andreacalvo/pcb_ble_corbera/README.md

## BLE Corbera

Kicad design, BLE Temperature Humidity sensor
