andreacalvo/pcb_ble_corbera/pcb_ble_corbera.kicad_pcb

## KiCad design pcb_ble_corbera.kicad_pcb (2018-05-15)

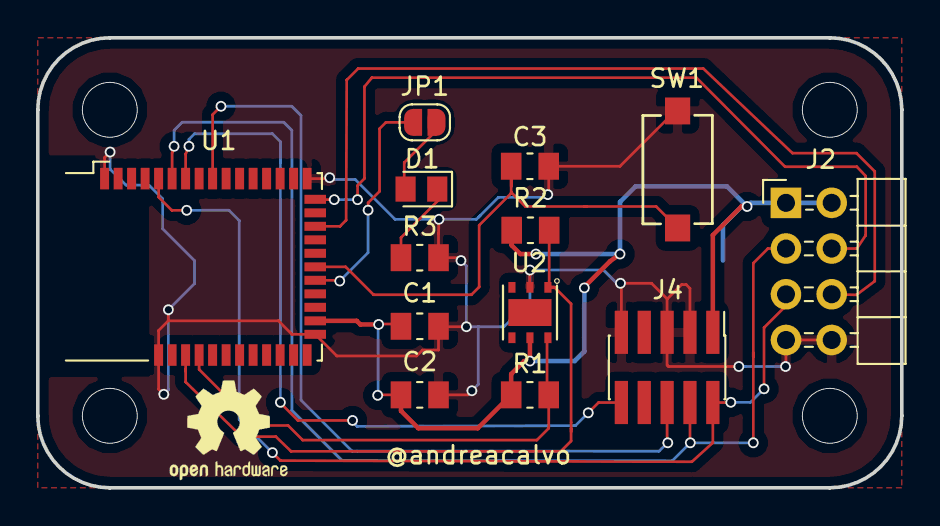
[picture p1: board pcb_ble_corbera.kicad_pcb from above]

Board: 2 copper layers, 48.0 x 25.0 mm, 14 parts (1 on the bottom side), 14 nets.

Parts:
C1: 0.1uF, 16V; C_0805_2012Metric_Pad1.15x1.50mm_HandSolder
C2: 100nF; C_0805_2012Metric_Pad1.15x1.50mm_HandSolder
C3: 104pF; C_0805_2012Metric_Pad1.15x1.50mm_HandSolder
D1: LED; LED_0805_2012Metric_Pad1.12x1.40mm_HandSolder
J1: Battery_Cell; Keystone_1058_1x2032-CoinCell
J2: Conn_02x04_Odd_Even; PinHeader_2x04_P2.54mm_Horizontal_No_Pins
J4: Conn_ARM_JTAG_SWD_10; PinHeader_2x05_P1.27mm_Vertical_SMD
JP1: SolderJumper_2_Open; SolderJumper-2_P1.3mm_Open_RoundedPad1.0x1.5mm
R1, R2: 5.7k; R_0805_2012Metric_Pad1.15x1.50mm_HandSolder
R3: 220R; R_0805_2012Metric_Pad1.15x1.50mm_HandSolder
SW1: SW_Push; SW_SMD_60X3.8
U1: BL652; Laird_BL652
U2: SHT20

Connections:
BUTTON_0: C3.1, SW1.2, U1.22
GND: C1.2, C2.2, C3.2, J1.2, J2.7, J2.8, J4.3, J4.5, J4.9, R3.2, SW1.1, U1.1, U1.16, U1.27, U1.39, U2.2
LED_0: JP1.2, U1.23
unnamed: D1.1, R3.1
unnamed: D1.2, JP1.1
RESET: J4.10, U1.7
SCL: R1.1, U1.36, U2.6
SDA: R2.1, U1.37, U2.1
SERIAL_RX: J2.6, U1.19
SERIAL_TX: J2.4, U1.17
SIO_18: J4.6, U1.9
SWDCLK: J2.3, J4.4, U1.6
SWDIO-TMS: J2.5, J4.2, U1.5
VCC: C1.1, C2.1, J1.1, J2.1, J2.2, J4.1, R1.2, R2.2, U1.26, U2.5
