andreacalvo/pcb_ble_corbera/(commit log)

2018-04-15 added bl652 and hdc1080 3D models
    [pcb_ble_corbera.kicad_pcb]
2018-04-16 added debug connector to the schematic
    [pcb_ble_corbera.sch]
2018-04-17 New page + BLE652 pins labels
    [pcb_ble_corbera.sch]
2018-04-17 New page + connectors interface
    [pcb_ble_corbera.sch]
2018-04-18 Global variables BL652 + 18 conectors
    [pcb_ble_corbera.sch]
2018-04-18 updated 18 pin connector
    [BL652.sch, Interface_Connectors.sch, Peripherals.sch, pcb_ble_corbera.sch]
2018-04-18 removed 2x18 pin connector from BL652 sheet
    [BL652.sch]
2018-04-18 tweaks for pcb layout
    [BL652.sch, Interface_Connectors.sch, Peripherals.sch, pcb_ble_corbera.kicad_pcb, pcb_ble_corbera.sch]
2018-04-20 reduced schematic, no header connectors
    [BL652.sch, Interface_Connectors.sch, pcb_ble_corbera.kicad_pcb, pcb_ble_corbera.sch]
2018-04-23 changed battery, switch, debug conn
    [BL652.sch, Interface_Connectors.sch, pcb_ble_corbera.kicad_pcb, pcb_ble_corbera.sch]
2018-04-24 new tracks
    [BL652.sch, Interface_Connectors.sch, pcb_ble_corbera.kicad_pcb, pcb_ble_corbera.sch]
2018-04-26 layout 90%
    [old_design.kicad_pcb, pcb_ble_corbera.kicad_pcb]
2018-04-28 added texts
    [pcb_ble_corbera.kicad_pcb]
2018-04-28 changed battery holder
    [pcb_ble_corbera.kicad_pcb]
2018-04-28 added battery holder 3d model
    [pcb_ble_corbera.kicad_pcb]
2018-04-28 changed battery holder in sch
    [pcb_ble_corbera.sch]
2018-05-14 changed hdc1080 with sht20
    [BL652.sch, Interface_Connectors.sch, pcb_ble_corbera.kicad_pcb, pcb_ble_corbera.sch]
2018-05-15 added kicad logo
    [pcb_ble_corbera.kicad_pcb]
