andreacalvo/pcb_ble_corbera/(notices)

Notices in the files:
pcb_ble_corbera.kicad_pcb:
ραυηεт©2018
